UCSD-Quadcopter-Class/quad-hardware-h_k_n/led_notes.txt

We design the LED to be connected to the battery. We added 10Kohm resistor so we should be safe. The resistor Datasheet is in the repo.
