UCSD-Quadcopter-Class/quad-hardware-h_k_n/design_reviews/questions_about_their_board.txt

- The vias should go all the way around all the antenna components

We meet in CSE 2209 on 5/3/2017 at 6:45PM
