UCSD-Quadcopter-Class/quad-hardware-h_k_n/design_reviews/questions_about_their_schematic.txt

Why did you take out the capacitor in the motor driver from PWM to ground ?

Why you didn't connect pin 12 and 33 ( ATMEL RF MICROCONTROLLER) to VCC ?

You have an extra RESET button on ht FTDI

We meet in the Makersapce on 4/24/2017 from 2 PM to 4:30 PM
