UCSD-Quadcopter-Class/quad-hardware-h_k_n/BOM_HKN.xlsx

Part | Value
B2 | BALUN0805
BATT1 | BATTERY-HUBSAN-W/HOLDER
BREAKOUT_HEADER
C1 | 12pF
C2 | 12pF
C3 | 1uF
C4 | 10uF
C5 | 220uF
C6 | 0.1uF
C7 | 220uF
C8 | 220uF
C9 | 0.75pF
C10 | 0.1uF
C11 | 1uF
C12 | 1uF
C13 | 0.1uF
C14 | 0.1uF
C15 | 0.1uF
C16 | 1uF
C17 | 10uF
C18 | 1uF
C19 | 0.1uF
C20 | 0.1uF
C21 | 0.01uF
C22 | 22pF
C23 | 1uF
C24 | 220uF
C25 | 220uF
D1 | 360mV
D2 | 360mV
D3 | 360mV
D4 | 360mV
D5 | green
D7 | Blue
D8 | Yellow
D9 | Orange
J1 | ISP
J2
J7
M1
M2
M3
M4
MOSFET1 | SI2302
MOSFET2 | SI2302
MOSFET3 | SI2302
MOSFET4 | SI2302
R1 | 10K
R2 | 10K
R3 | 330
R4 | 330
R5 | 10K
R6 | 10K
R7 | 330
R8 | 10K
R9 | 330
R11 | 10K
R12 | 100
R13 | 10K
R14 | 100
R15 | 10K
R16 | 100
R17 | 10K
R18 | 100
RX_LED | green
RX_R | 330
SERIAL_DEBUGGER | FTDI
SERIAL_PROGRAMMER | FTDI
SWRESET | PUSHBUTTON_SMD-VERTICAL-1
TX_LED | green
TX_R | 330
U$1 | MOTOR_PADS
U$2 | MOTOR_PADS
U$3 | MOTOR_PADS
U$4 | MOTOR_PADS
U$5 | ANTENNA2SMD5
U$6 | IMULAST
U$7 | WIRE_BRIDGE
U$9 | TPS73633-DBVT
U2 | ATMEGA128RFA1
Y2
