UCSD-Quadcopter-Class/quad-hardware-h_k_n/quadcopter.brd

## EAGLE design quadcopter.brd (2017-05-30)

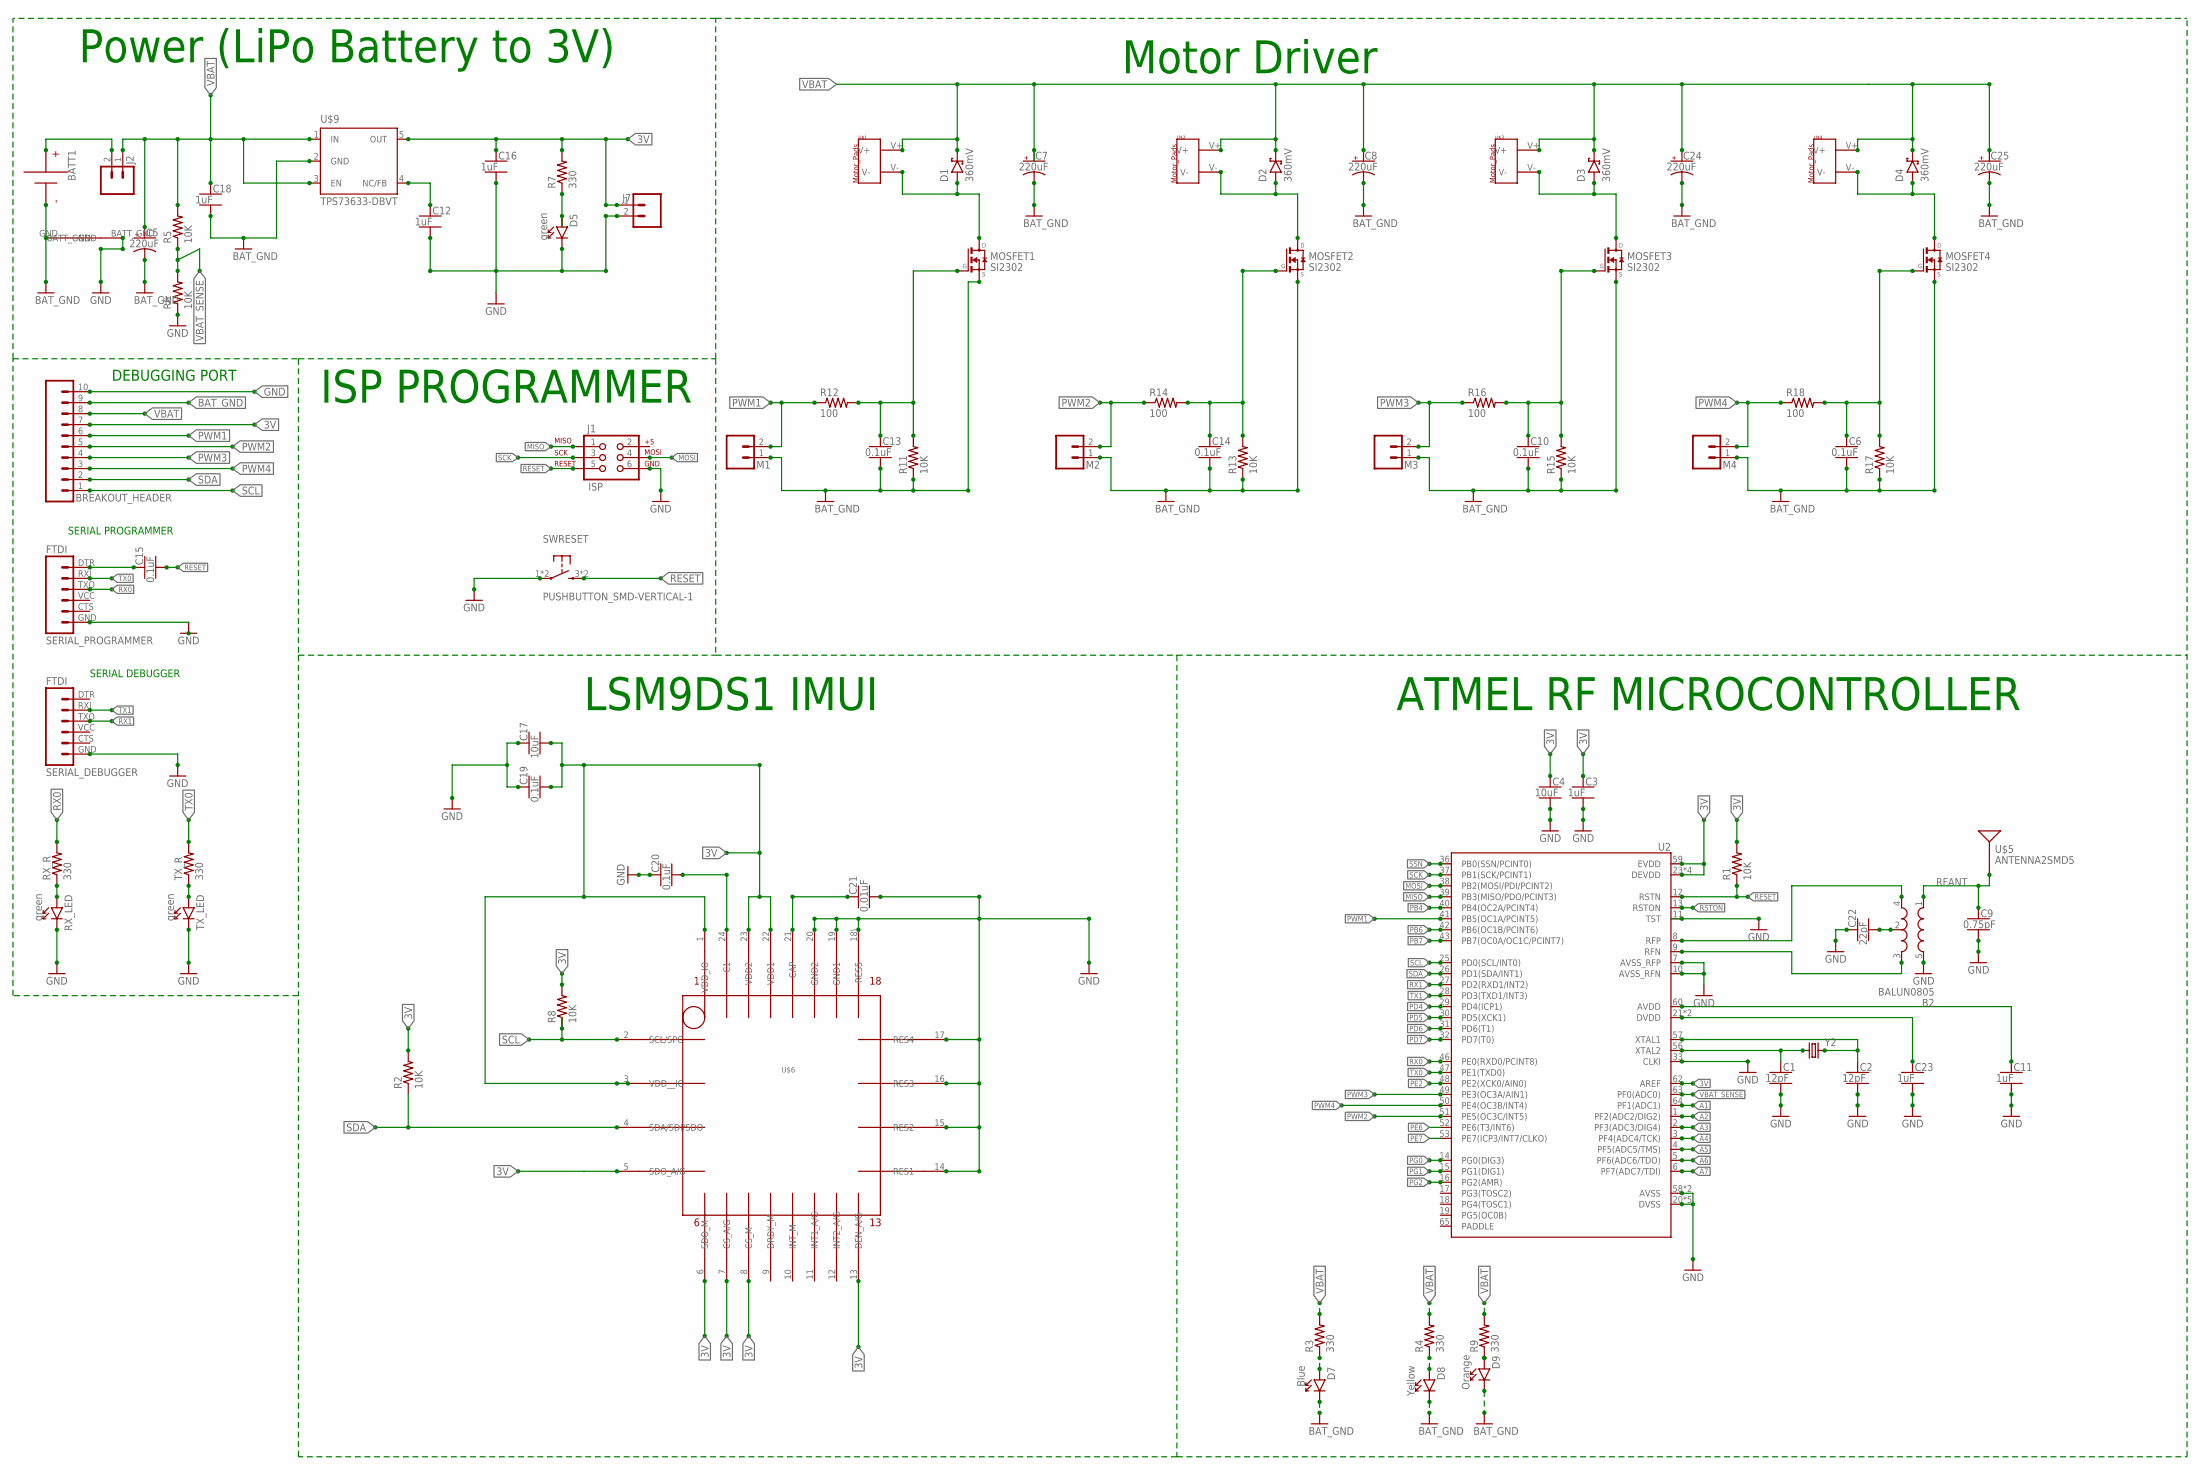
[picture p1: schematic quadcopter.sch]

Parts:
B2: BALUN0805; BALUN
BATT1: BATTERY-HUBSAN-W/HOLDER; BATTERY-W/HOLDER-380MAH-HUBSAN
BREAKOUT_HEADER: SIP-10_TH-254X10; HDRV10W63P254_10X1_2540X254H838_HS
C1, C2: 12pF; CAPC2012X140_HS
C3, C11, C12, C16, C18, C23: 1uF; CAPC2012X140_HS
C4, C17: 10uF; CAPC2012X140_HS
C5, C7, C8, C24, C25: 220uF; CAPMP7343X310_HS
C6, C10, C13, C14, C15, C19, C20: 0.1uF; CAPC2012X140_HS
C9: 0.75pF; CAPC2012X140_HS
C21: 0.01uF; CAPC2012X140_HS
C22: 22pF; CAPC2012X140_HS
D1, D2, D3, D4: 360mV; SOD3716X135_HS
D5: green; LEDSC125X200X120-2_HS
D7: Blue; LEDSC125X200X120-2_HS
D8: Yellow; LEDSC125X200X120-2_HS
D9: Orange; LEDSC125X200X120-2_HS
J1: ISP; 2X3-NS
J2, J7: MALE_HEADER_2POS-2X1-0.1IN; MALE_HEADER_2X1_0.1IN
M1, M2, M3, M4: MALE_HEADER_2POS-2X1-0.1IN; MALE_HEADER_2X1_0.1IN
MOSFET1, MOSFET2, MOSFET3, MOSFET4: SI2302; SOT23
R1, R2, R5, R6, R8, R11, R13, R15, R17: 10K; RESC2012X60_HS
R3, R4, R7, R9: 330; RESC2012X60_HS
R12, R14, R16, R18: 100; RESC2012X60_HS
RX_LED: green; LEDSC125X200X120-2_HS
RX_R: 330; RESC2012X60_HS
SERIAL_DEBUGGER: FTDI; FTDI_BASIC
SERIAL_PROGRAMMER: FTDI; FTDI_BASIC
SWRESET: PUSHBUTTON_SMD-VERTICAL-1; TE_FSM8JSMA_HS
TX_LED: green; LEDSC125X200X120-2_HS
TX_R: 330; RESC2012X60_HS
U2: ATMEGA128RFA1; QFN-64
U$1, U$2, U$3, U$4: MOTOR_PADS
U$5: ANTENNA2SMD5; ANTENNA-CHIP5
U$6: IMULAST; LGA-24/4MM
U$7: WIRE_BRIDGE; WIRE_BRIGE
U$9: TPS73633-DBVT; SOT23-DBV
Y2: CRYSTAL5X3; CRYSTAL-SMD-5X3

Connections:
3V: BREAKOUT_HEADER.7, C3.1, C4.1, C16.1, C17.2, C19.2, J7.1, R1.2, R2.2, R7.2, R8.2, U2.23 (DEVDD), U2.34 (DEVDD), U2.44 (DEVDD), U2.54 (DEVDD), U2.59 (EVDD), U2.62 (AREF), U$6.1 (VDD_IO), U$6.3 (VDD__IO), U$6.5 (SDO_A/G), U$6.6 (SDO_M), U$6.7 (CS_A/G), U$6.8 (CS_M), U$6.13 (DEN_A/G), U$6.22 (VDD1), U$6.23 (VDD2), U$9.5 (OUT)
A1: U2.64 (PF1(ADC1))
A2: U2.1 (PF2(ADC2/DIG2))
A3: U2.2 (PF3(ADC3/DIG4))
A4: U2.3 (PF4(ADC4/TCK))
A5: U2.4 (PF5(ADC5/TMS))
A6: U2.5 (PF6(ADC6/TDO))
A7: U2.6 (PF7(ADC7/TDI))
AVDD: C11.1, U2.60 (AVDD)
BAT_GND: BATT1.- (N), BREAKOUT_HEADER.9, C5.2 (-), C6.2, C7.2 (-), C8.2 (-), C10.2, C13.2, C14.2, C18.2, C24.2 (-), C25.2 (-), D7.C, D8.C, D9.C, M1.1, M2.1, M3.1, M4.1, MOSFET1.2 (S), MOSFET2.2 (S), MOSFET3.2 (S), MOSFET4.2 (S), R11.1, R13.1, R15.1, R17.1, U$7.GND, U$9.2 (GND)
DTR: C15.1, SERIAL_PROGRAMMER.DTR (1)
DVDD: C23.1, U2.21 (DVDD), U2.22 (DVDD)
GND: B2.5 (GND), BREAKOUT_HEADER.10, C1.2, C2.2, C3.2, C4.2, C9.2, C11.2, C12.2, C16.2, C17.1, C19.1, C20.1, C21.2, C22.1, C23.2, D5.C, J1.6, J7.2, R6.1, RX_LED.C, SERIAL_DEBUGGER.GND (6), SERIAL_PROGRAMMER.GND (6), SWRESET.1, SWRESET.2 (1), TX_LED.C, U2.7 (AVSS_RFP), U2.10 (AVSS_RFN), U2.11 (TST), U2.20 (DVSS), U2.24 (DVSS), U2.33 (CLKI), U2.35 (DVSS), U2.45 (DVSS), U2.55 (DVSS), U2.58 (AVSS), U2.61 (AVSS), U$6.14 (RES1), U$6.15 (RES2), U$6.16 (RES3), U$6.17 (RES4), U$6.18\ (RES5), U$6.19 (GND1), U$6.20 (GND2), U$7.BATT_GND
MISO: J1.1, U2.39 (PB3(MISO/PDO/PCINT3))
MOSI: J1.4, U2.38 (PB2(MOSI/PDI/PCINT2))
unnamed: C13.1, MOSFET1.1 (G), R11.2, R12.2
unnamed: C2.1, U2.57 (XTAL1), Y2.3 (2)
unnamed: C1.1, U2.56 (XTAL2), Y2.1
unnamed: B2.2 (GND), C22.2
unnamed: D9.A, R9.1
unnamed: D1.A, MOSFET1.3 (D), U$1.V-
unnamed: BATT1.+, J2.2
unnamed: D5.A, R7.1
unnamed: D2.A, MOSFET2.3 (D), U$2.V-
unnamed: TX_LED.A, TX_R.1
unnamed: RX_LED.A, RX_R.1
unnamed: C20.2, U$6.24 (C1)
unnamed: D3.A, MOSFET3.3 (D), U$3.V-
unnamed: C12.1, U$9.4 (NC/FB)
unnamed: D8.A, R4.1
unnamed: D7.A, R3.1
unnamed: D4.A, MOSFET4.3 (D), U$4.V-
unnamed: C21.1, U$6.21 (CAP)
unnamed: C14.1, MOSFET2.1 (G), R13.2, R14.2
unnamed: C10.1, MOSFET3.1 (G), R15.2, R16.2
unnamed: C6.1, MOSFET4.1 (G), R17.2, R18.2
PB4: U2.40 (PB4(OC2A/PCINT4))
PB6: U2.42 (PB6(OC1B/PCINT6))
PB7: U2.43 (PB7(OC0A/OC1C/PCINT7))
PD4: U2.29 (PD4(ICP1))
PD5: U2.30 (PD5(XCK1))
PD6: U2.31 (PD6(T1))
PD7: U2.32 (PD7(T0))
PE2: U2.48 (PE2(XCK0/AIN0))
PE6: U2.52 (PE6(T3/INT6))
PE7: U2.53 (PE7(ICP3/INT7/CLKO))
PG0: U2.14 (PG0(DIG3))
PG1: U2.15 (PG1(DIG1))
PG2: U2.16 (PG2(AMR))
PWM1: BREAKOUT_HEADER.6, M1.2, R12.1, U2.41 (PB5(OC1A/PCINT5))
PWM2: BREAKOUT_HEADER.5, M2.2, R14.1, U2.51 (PE5(OC3C/INT5))
PWM3: BREAKOUT_HEADER.4, M3.2, R16.1, U2.49 (PE3(OC3A/AIN1))
PWM4: BREAKOUT_HEADER.3, M4.2, R18.1, U2.50 (PE4(OC3B/INT4))
RESET: C15.2, J1.5, R1.1, SWRESET.3 (2), SWRESET.4 (2), U2.12 (RSTN)
RFANT: B2.1 (IN), C9.1, U$5.FEED
RFN: B2.3 (OUT2), U2.9 (RFN)
RFP: B2.4 (OUT1), U2.8 (RFP)
RSTON: U2.13 (RSTON)
RX0: RX_R.2, SERIAL_PROGRAMMER.TXO (3), U2.46 (PE0(RXD0/PCINT8))
RX1: SERIAL_DEBUGGER.TXO (3), U2.27 (PD2(RXD1/INT2))
SCK: J1.3, U2.37 (PB1(SCK/PCINT1))
SCL: BREAKOUT_HEADER.1, R8.1, U2.25 (PD0(SCL/INT0)), U$6.2 (SCL/SPC)
SDA: BREAKOUT_HEADER.2, R2.1, U2.26 (PD1(SDA/INT1)), U$6.4 (SDA/SDI/SDO)
SSN: U2.36 (PB0(SSN/PCINT0))
TX0: SERIAL_PROGRAMMER.RXI (2), TX_R.2, U2.47 (PE1(TXD0))
TX1: SERIAL_DEBUGGER.RXI (2), U2.28 (PD3(TXD1/INT3))
VBAT: BREAKOUT_HEADER.8, C5.1 (+), C7.1 (+), C8.1 (+), C18.1, C24.1 (+), C25.1 (+), D1.C, D2.C, D3.C, D4.C, J2.1, R3.2, R4.2, R5.2, R9.2, U$1.V+, U$2.V+, U$3.V+, U$4.V+, U$9.1 (IN), U$9.3 (EN)
VBAT_SENSE: R5.1, R6.2, U2.63 (PF0(ADC0))

Notes on the sheet:
Motor Driver
Power (LiPo Battery to 3V)
ISP PROGRAMMER
DEBUGGING PORT
SERIAL DEBUGGER
SERIAL PROGRAMMER
LSM9DS1 IMUI
ATMEL RF MICROCONTROLLER

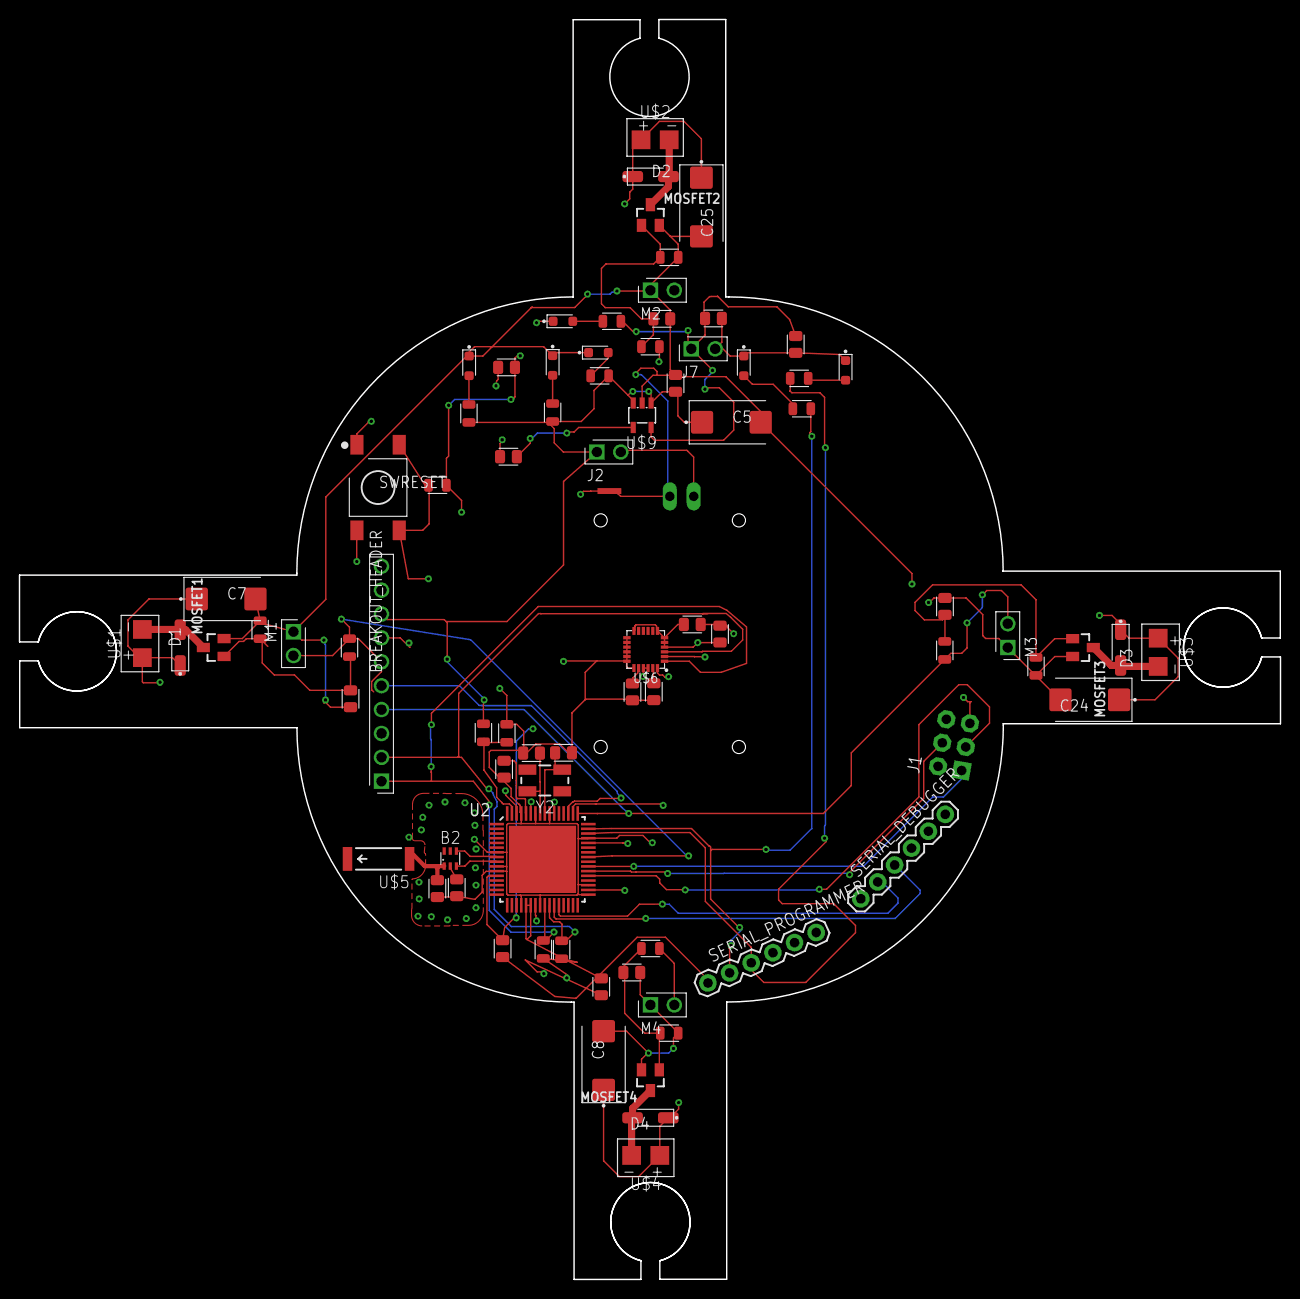
[picture p2: board quadcopter.brd from above]

Board: 4 copper layers, 134.1 x 134.0 mm, 81 parts (1 on the bottom side), 46 nets.
