UCSD-Quadcopter-Class/quad-hardware-h_k_n/(commit log)

2017-04-27 instructior review of original schematic
2017-04-27 fixing repo
    [quadcopter.sch]
2017-05-01 Add files via upload
    Board Layout
    [quadcopter.brd, quadcopter.sch]
2017-05-04 swanson schematic review
    [quadcopter.sch]
2017-05-14 more schematic comments from swanson
2017-05-15 Fixed Schematic but still not able to root 90%
    [quadcopter.brd, quadcopter.sch]
2017-05-17 Route 100% FINALLY.
    [quadcopter.brd, quadcopter.sch]
2017-05-23 board comments from swanson
2017-05-25 After fixing professor's comments
    [quadcopter.brd, quadcopter.sch]
2017-05-27 more board comments from swanson
2017-05-29 After fixing professor's comments V2
    [quadcopter.brd, quadcopter.sch]
2017-05-29 After fixing professor's comments V3
    [quadcopter.brd]
2017-05-29 After fixing professor's comments V3 (Fixed wires)
    [quadcopter.brd]
2017-05-30 After fixing professor's comments V4 (GND)
    [quadcopter.brd, quadcopter.sch]
